Batibaran/Doorbell-IoT/(commit log)

2025-11-05 add arduino code without sensitive information
2025-11-05 add proteus schematic
2025-11-05 add sample python code for unlocking remotely
